shimniok/eeZeeTiny841/README.md

eeZeeTiny841 is a breakout / target board for breadboarding with the powerful ATtiny841.

[Click here for the User Guide](documentation/README.md)
