shimniok/eeZeeTiny841/examples/avr-gcc/fuses/README.md

Conveniently update fuses with avrdude

 * ```make xtal``` to update fuses for an onboard crystal
 * ```make noxtal``` to update fuses for the internal oscillator
