shimniok/eeZeeTiny841/electronics/eeZeeTiny841.brd

## EAGLE design electronics/eeZeeTiny841.brd (2016-03-16)

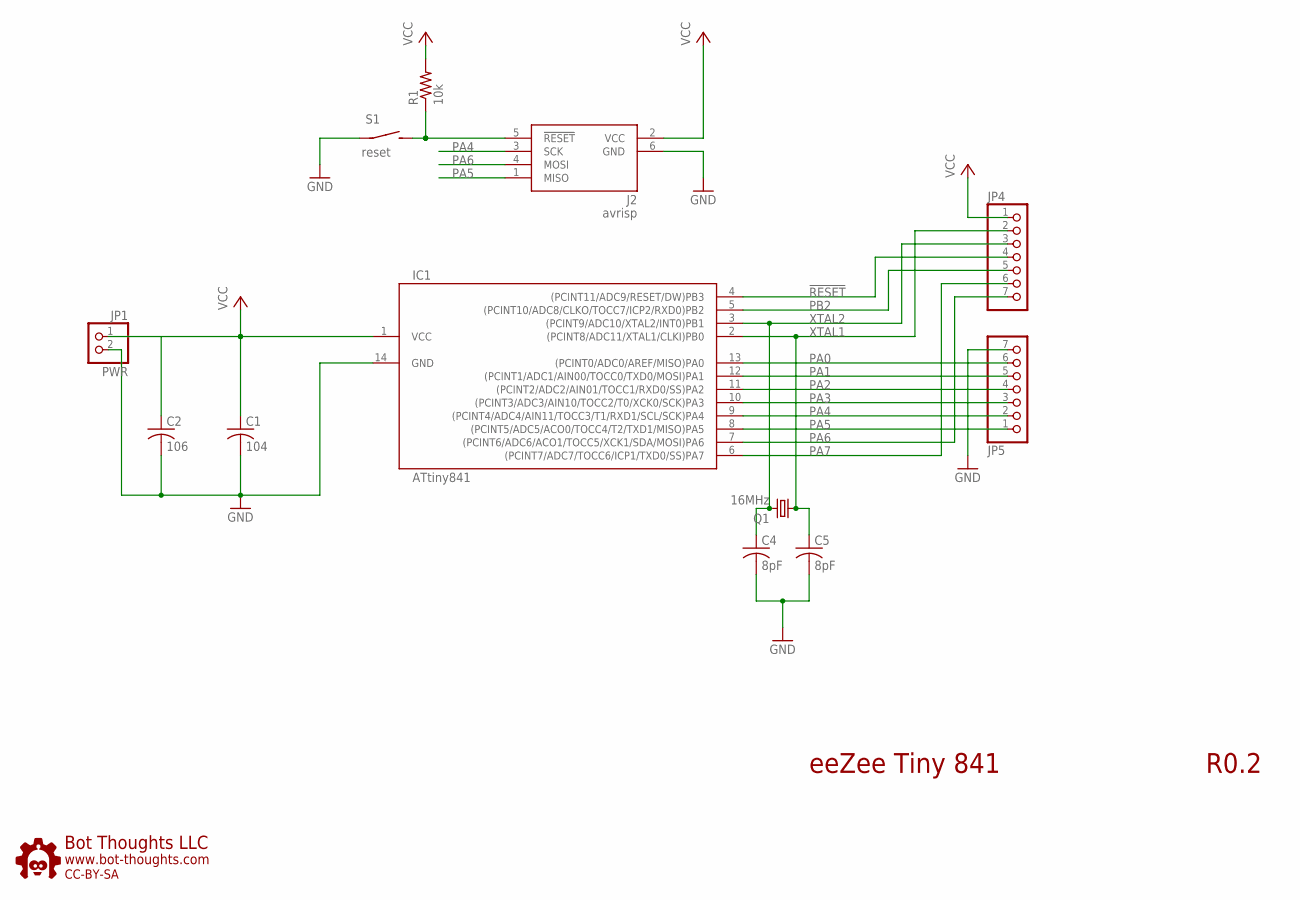
[picture p3: schematic eeZeeTiny841.sch]

Parts:
C1: 104; C0603; PARTNO 0603YC104KAT2A
C2: 106; C1206; PARTNO MCTT21X106M6R3CT
C4, C5: 8pF; C0603; PARTNO 0603YC104KAT2A
IC1: ATtiny841; 14SOICN
J2: avrisp; CON6P2R
JP1: PWR; 1X02-S
JP4, JP5: PINHD-1X07_2.54-S; 1X07-S
Q1: 16MHz; NDK_2PAD_5X3
R1: 10k; R0603; PARTNO ERJ-3GEYJ103V
S1: reset; 6MMTACTILE_RECT
U$1: BTLOGO-LOGO-MD; BTLOGOM

Connections:
!RESET: IC1.4 ((PCINT11/ADC9/RESET/DW)PB3), J2.5 (!RESET), JP4.4, R1.1, S1.P$2 (S)
GND: C1.2, C2.2, C4.2, C5.2, IC1.14 (GND), J2.6 (GND), JP1.2, JP5.7, S1.P$1
PA0: IC1.13 ((PCINT0/ADC0/AREF/MISO)PA0), JP5.6
PA1: IC1.12 ((PCINT1/ADC1/AIN00/TOCC0/TXD0/MOSI)PA1), JP5.5
PA2: IC1.11 ((PCINT2/ADC2/AIN01/TOCC1/RXD0/SS)PA2), JP5.4
PA3: IC1.10 ((PCINT3/ADC3/AIN10/TOCC2/T0/XCK0/SCK)PA3), JP5.3
PA4: IC1.9 ((PCINT4/ADC4/AIN11/TOCC3/T1/RXD1/SCL/SC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), J2.3 (SCK), JP5.2
PA5: IC1.8 ((PCINT5/ADC5/ACO0/TOCC4/T2/TXD1/MISO)PA5), J2.1 (MISO), JP5.1
PA6: IC1.7 ((PCINT6/ADC6/ACO1/TOCC5/XCK1/SDA/MOSI)P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), J2.4 (MOSI), JP4.7
PA7: IC1.6 ((PCINT7/ADC7/TOCC6/ICP1/TXD0/SS)PA7), JP4.6
PB2: IC1.5 ((PCINT10/ADC8/CLKO/TOCC7/ICP2/RXD0)PB2), JP4.5
VCC: C1.1, C2.1, IC1.1 (VCC), J2.2 (VCC), JP1.1, JP4.1, R1.2
XTAL1: C5.1, IC1.2 ((PCINT8/ADC11/XTAL1/CLKI)PB0), JP4.2, Q1.P$1 (1)
XTAL2: C4.1, IC1.3 ((PCINT9/ADC10/XTAL2/INT0)PB1), JP4.3, Q1.P$2 (2)

Notes on the sheet:
eeZee Tiny 841
R0.2

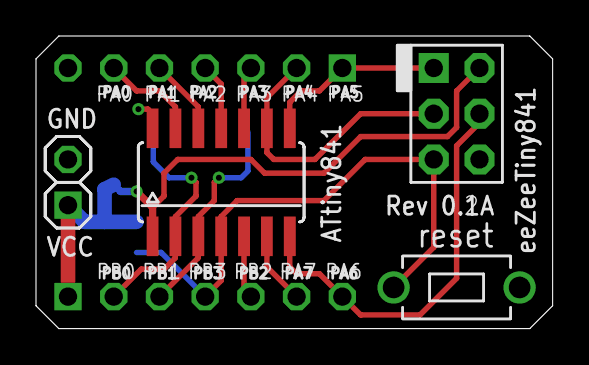
[picture p4: board eeZeeTiny841.brd from above]

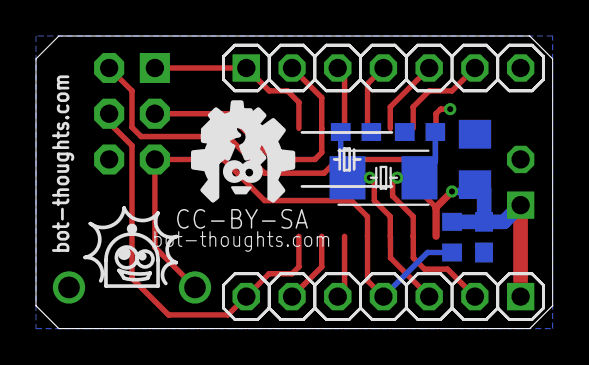
[picture p5: board eeZeeTiny841.brd from below]

Board: 2 copper layers, 28.7 x 16.3 mm, 13 parts (9 on the bottom side), 14 nets.
