shimniok/eeZeeTiny841/setup/README.md

For installation instructions, refer to the [documentation/](https://github.com/shimniok/eeZeeTiny841/tree/master/documentation) directory of this repo.
