shimniok/eeZeeTiny841/documentation/images/assembly0.jpg

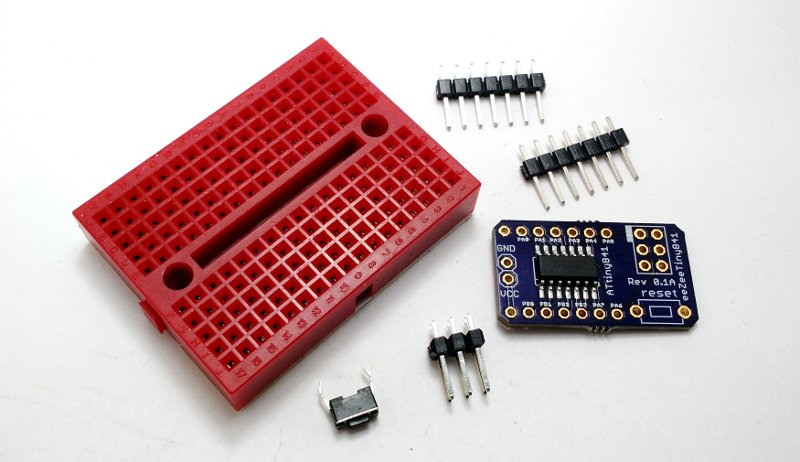
documentation/images/assembly0.jpg
