shimniok/eeZeeTiny841/(commit log)

2014-01-22 Initial draft revision 0.1
    [eeZeeTiny841.brd, eeZeeTiny841.sch]
2014-01-22 Fixing accidentally flipped schematic. D'oye!
2014-03-01 Minor mods to board/schematic. avrdude config from AVRfreaks forum.
    [eeZeeTiny841.brd, eeZeeTiny841.sch]
2014-03-01 Revised to use non-reset, non-xtal pins.
    [main.c]
2014-03-01 Revised hierarchy with electronics subdir
    [eeZeeTiny841.brd, eeZeeTiny841.sch]
2014-03-18 Fixed char / addition / subtraction bug, converted to larson type scanning, back and forth.
    [larson.c]
2014-10-17 Converted to 10mil/8mil spacing, changed PTHs to octagon.
    [eeZeeTiny841.brd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]
2015-04-24 minor reformat. fixed loop variables. changed delay
    [larson.c]
2015-11-17 Updated to current user guie format. Included additional soldering pics and instructions. Converted some images to local.
2015-11-18 added assembly pictures
2016-02-11 fixed makefile fuse formatting, provided option for external clock
2016-02-12 added fuses, minor reformatting
2016-02-25 added makefile for setting fuses conveniently for xtal vs. no onboard xtal.
2016-02-25 added Arduino larsen example
2016-02-25 updated pinout with arduino pins, added source xcf
2016-02-25 updated user guide, reorganized arduino vs. gcc, modified pinout image size for ISP
2016-03-16 revised layout, updated logo
    [eeZeeTiny841.brd, eeZeeTiny841.sch]
2016-03-16 updated gerbers, zip
    [eeZeeTiny841.drills.xln]
2017-05-17 Created file for adding AVR Dragon to arduino
2017-05-17 Updated fuses, removed Wire reference
2017-06-26 Separated board assy instructions into separate file
