shimniok/eeZeeTiny841/(notices)

Notices in the files:
electronics/eeZeeTiny841.brd:
CC-BY-SA
